NajdBS/2627_ESE_PROJET_BMO/README.md

# 2627_ESE_PROJET_BMO
# Robot BMO - Ramasseur de Canettes
Projet d'Option 3A ESE (2026-2027)

## Équipe
- Najd BEN SAAD
- Achraf AHAL
- Yassin GARAFI
