NajdBS/2627_ESE_PROJET_BMO/docs/Composants_BMO.xlsx

ROBOT GARBAGE COLLECTOR - CODE NAME : BMO
Composant | Reference suggeree | Qte | A quoi ca sert (Role) | Emplacement | Option
Microcontroleur (Cerveau) | STM32G431RBT6 OU STM32G474RBT3 (In Stock: 3,342) | 1 | Controle general, RTOS, asservissement moteurs | Soude sur PCB | Commun (Obligatoire)
Driver Moteurs | DRV8833PWPR | 1 | Pilote les 2 roues motrices (vitesse et sens) | Soude sur PCB | Commun (Obligatoire)
Chargeur + Boost 5V | BQ25896RTWR | 1 | Charge USB-C + alimente le robot en 5V (3.1A) | Soude sur PCB | Commun (Obligatoire)
Regulateur 3.3V | BU33SD5WG-TR | 1 | Alimente le STM32, l ecran et les capteurs I2C | Soude sur PCB | Commun (Obligatoire)
Gyroscope (IMU) | MPU6050 | 1 | Evite que BMO ne devie dans les virages | Soude sur PCB | Commun (Obligatoire)
Prise USB-C | Embase USB-C | 1 | Recharge de la batterie | Soude sur PCB | Commun (Obligatoire)
Prise Programmation | Header SWD (5 pins) | 1 | Flash et debogage du code via ST-Link | Soude sur PCB | Commun (Obligatoire)
Moteurs Roues | DFRobot FIT0483 | 2 | Propulsion differentielle + encodeurs de tours | Branche au PCB | Commun (Obligatoire)
Servo Pince | DFRobot SER0039 | 1 | Ouvre et serre la canette | Branche au PCB | Commun (Obligatoire)
Capteur Couleur | Adafruit APDS-9960 | 1 | Reconnait si la canette est rouge ou verte | Branche au PCB | Commun (Obligatoire)
Capteurs Sol (Anti-chute) | VL53L0X (ToF) | 2 | Detecte le bord de table pour ne pas tomber | Branche au PCB | Commun (Obligatoire)
Batterie | Li-ion 1S (3.7V) | 1 | Alimentation autonome du robot (~2200 mAh) | Branche au PCB | Commun (Obligatoire)
Ecran Visage BMO (Grand) | OLED 1.3 I2C (SH1106 / SSD1306) | 1 | Affiche les expressions / yeux de BMO en grand format | Branche au PCB | Retenu (BMO)
Telemetrie Sans Fil | Module BLE (HM-10) ou ESP | 1 | Envoie les donnees live (batterie, etat) sur PC/tel | Branche au PCB | Retenu (BMO)
LED Blanche Eclairage | LED Blanche Haute Luminosite (5mm/CMS) | 1 | Eclaire la canette dans la pince pour fiabiliser la couleur en zone sombre | Branche au PCB | Retenu (BMO)
LiDAR 360 | LD06 / RPLIDAR | 1 | Vision 360 : voit canettes et autres robots | Branche au PCB | Option A (LiDAR)
Capteurs ToF Avant | VL53L0X | 3 | Detecte les canettes en arc fixe (sans moteur) | Branche au PCB | Option B (3 ToF)
