NajdBS/2627_ESE_PROJET_BMO/BMO/Motors.kicad_sch

## KiCad design BMO/Motors.kicad_sch (2026-11-05)

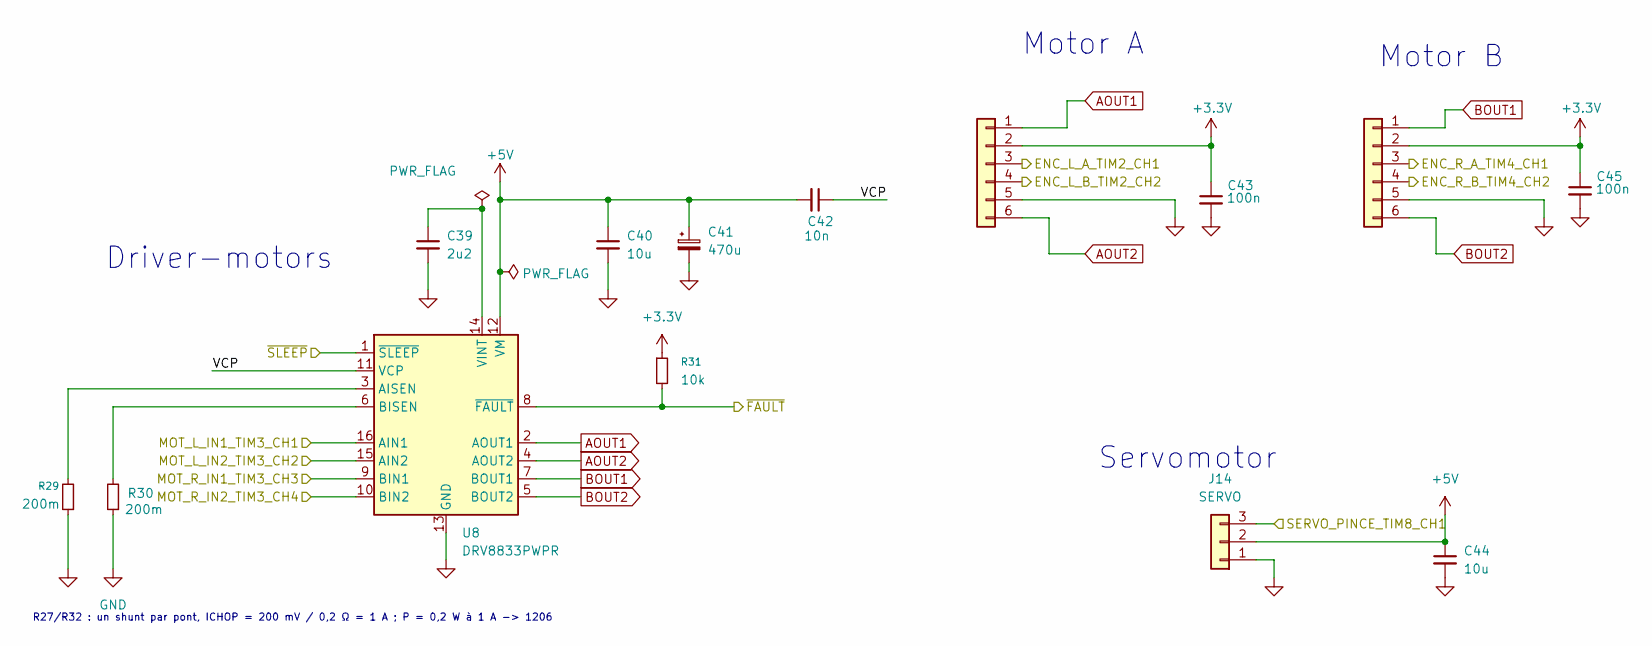
[picture p1: schematic Motors.kicad_sch]

Parts:
C39: 2u2; C_0402_1005Metric; JLCPCB Part # C12530
C40, C44: 10u; C_0603_1608Metric; JLCPCB Part # C96446
C41: 470u; CP_Elec_10x10; JLCPCB Part # C2165185
C42: 10n; C_0402_1005Metric; JLCPCB Part # C15195
C43, C45: 100n; C_0402_1005Metric; JLCPCB Part # C1525
J13, J15: Conn_01x06; JST_XH_S6B-XH-A_1x06_P2.50mm_Horizontal; JLCPCB Part # C157919
J14: SERVO; JST_XH_S3B-XH-A-1_1x03_P2.50mm_Horizontal; JLCPCB Part # C163036
R29: 200m; R_2512_6332Metric; JLCPCB Part # C83749
R30: 200m; R_2512_6332Metric; LCSC C83749
R31: 10k; R_0402_1005Metric; JLCPCB Part # C25744
U8: DRV8833PWPR; HTSSOP-16-1EP_4.4x5mm_P0.65mm_EP3.4x5mm_Mask2.46x2.31mm_The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; JLCPCB Part # C50506

Connections:
+3.3V: C43.1, C45.1, J13.2, J15.2, R31.1
+5V: C40.1, C41.1, C42.2, C44.1, J14.2, U8.12 (VM)
AOUT1: J13.1, U8.2 (AOUT1)
AOUT2: J13.6, U8.4 (AOUT2)
BOUT1: J15.1, U8.7 (BOUT1)
BOUT2: J15.6, U8.5 (BOUT2)
ENC_L_A_TIM2_CH1: J13.3
ENC_L_B_TIM2_CH2: J13.4
ENC_R_A_TIM4_CH1: J15.3
ENC_R_B_TIM4_CH2: J15.4
GND: C39.2, C40.2, C41.2, C43.2, C44.2, C45.2, J13.5, J14.1, J15.5, R29.1, R30.1, U8.13 (GND), U8.17 (GND)
MOT_L_IN1_TIM3_CH1: U8.16 (AIN1)
MOT_L_IN2_TIM3_CH2: U8.15 (AIN2)
MOT_R_IN1_TIM3_CH3: U8.9 (BIN1)
MOT_R_IN2_TIM3_CH4: U8.10 (BIN2)
unnamed: C39.1, U8.14 (VINT)
unnamed: R29.2, U8.3 (AISEN)
unnamed: R30.2, U8.6 (BISEN)
SERVO_PINCE_TIM8_CH1: J14.3
VCP: C42.1, U8.11 (VCP)
~FAULT: R31.2, U8.8 (~FAULT)
~SLEEP: U8.1 (~SLEEP)

Notes on the sheet:
Driver-motors
R27/R32 : un shunt par pont, ICHOP = 200 mV / 0,2 Ω = 1 A ; P = 0,2 W à 1 A -> 1206
Motor A
Servomotor
Motor B
