NajdBS/2627_ESE_PROJET_BMO/BMO/STM32G474RBT3.kicad_sch

## KiCad design BMO/STM32G474RBT3.kicad_sch (2026-11-05)

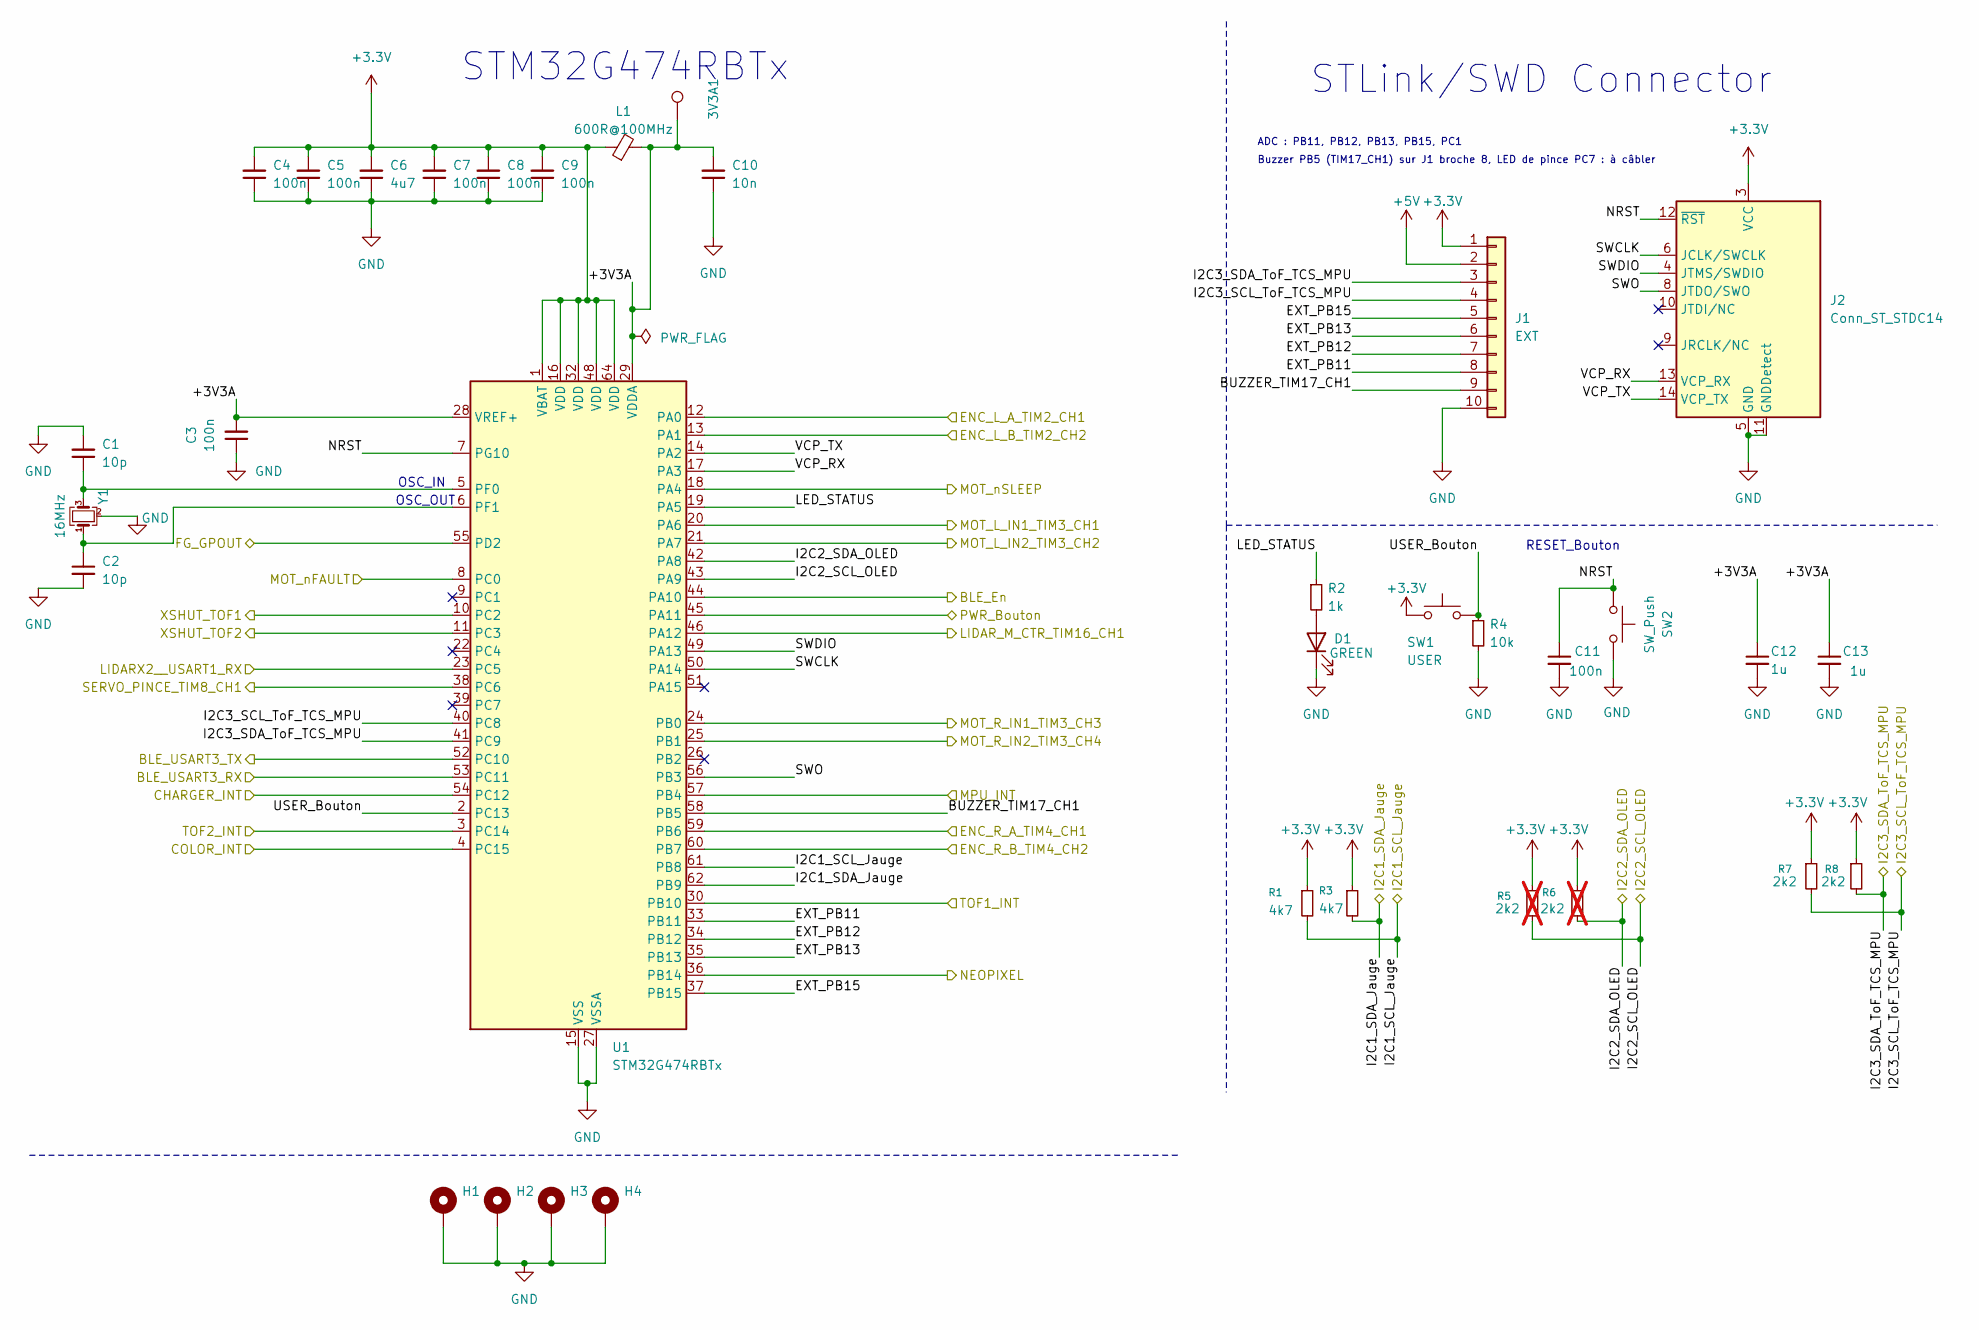
[picture p2: schematic STM32G474RBT3.kicad_sch]

Parts:
3V3A1: TestPoint; TestPoint_Pad_D1.5mm
C1, C2: 10p; C_0402_1005Metric; JLCPCB Part # C32949
C3, C4, C5, C7, C8, C9, C11: 100n; C_0402_1005Metric; JLCPCB Part # C1525
C6: 4u7; C_0603_1608Metric; JLCPCB Part # C19666
C10: 10n; C_0603_1608Metric; JLCPCB Part # C57112
C12, C13: 1u; C_0402_1005Metric; JLCPCB Part # C52923
D1: GREEN; LED_0603_1608Metric; JLCPCB Part # C12624
H1, H2, H3, H4: MountingHole_Pad; MountingHole_3.2mm_M3_Pad_Via
J1: EXT; PinHeader_1x10_P2.54mm_Vertical; JLCPCB Part # C492409
J2: Conn_ST_STDC14; PinHeader_2x07_P1.27mm_Vertical_SMD; JLCPCB Part # C5307809
L1: 600R@100MHz; L_0603_1608Metric; JLCPCB Part # C1002
R1, R3: 4k7; R_0603_1608Metric; JLCPCB Part # C23162
R2: 1k; R_0402_1005Metric; JLCPCB Part # C11702
R4: 10k; R_0402_1005Metric; JLCPCB Part # C25744
R5, R6: 2k2; R_0603_1608Metric; JLCPCB Part # C4190; not fitted
R7, R8: 2k2; R_0603_1608Metric; JLCPCB Part # C4190
SW1: USER; SW_Push_1P1T_NO_CK_KMR2; JLCPCB Part # C72443
SW2: SW_Push; SW_Push_1P1T_NO_CK_KMR2; JLCPCB Part # C72443
U1: STM32G474RBTx; LQFP-64_10x10mm_P0.5mm; JLCPCB Part # C1235414
Y1: 16MHz; Crystal_SMD_3225-4Pin_3.2x2.5mm; JLCPCB Part # C13738

Connections:
+3.3V: C4.2, C5.2, C6.2, C7.2, C8.2, C9.2, J1.1, J2.3 (VCC), L1.1, R1.1, R3.1, R5.2, R6.2, R7.1, R8.1, SW1.1, U1.1 (VBAT), U1.16 (VDD), U1.32 (VDD), U1.48 (VDD), U1.64 (VDD)
+3V3A: 3V3A1.1, C3.2, C10.2, C12.1, C13.1, L1.2, U1.28 (VREF+), U1.29 (VDDA)
+5V: J1.2
BLE_En: U1.44 (PA10)
BLE_USART3_RX: U1.53 (PC11)
BLE_USART3_TX: U1.52 (PC10)
BUZZER_TIM17_CH1: J1.9, U1.58 (PB5)
CHARGER_INT: U1.54 (PC12)
COLOR_INT: U1.4 (PC15)
ENC_L_A_TIM2_CH1: U1.12 (PA0)
ENC_L_B_TIM2_CH2: U1.13 (PA1)
ENC_R_A_TIM4_CH1: U1.59 (PB6)
ENC_R_B_TIM4_CH2: U1.60 (PB7)
EXT_PB11: J1.8, U1.33 (PB11)
EXT_PB12: J1.7, U1.34 (PB12)
EXT_PB13: J1.6, U1.35 (PB13)
EXT_PB15: J1.5, U1.37 (PB15)
FG_GPOUT: U1.55 (PD2)
GND: C1.2, C2.2, C3.1, C4.1, C5.1, C6.1, C7.1, C8.1, C9.1, C10.1, C11.2, C12.2, C13.2, D1.1 (K), H1.1, H2.1, H3.1, H4.1, J1.10, J2.5 (GND), J2.7 (GND), J2.11 (GNDDetect), R4.2, SW2.2, U1.15 (VSS), U1.27 (VSSA), U1.31 (VSS), U1.47 (VSS), U1.63 (VSS), Y1.2 (G), Y1.4 (G)
I2C1_SCL_Jauge: R1.2, U1.61 (PB8)
I2C1_SDA_Jauge: R3.2, U1.62 (PB9)
I2C2_SCL_OLED: R5.1, U1.43 (PA9)
I2C2_SDA_OLED: R6.1, U1.42 (PA8)
I2C3_SCL_ToF_TCS_MPU: J1.4, R7.2, U1.40 (PC8)
I2C3_SDA_ToF_TCS_MPU: J1.3, R8.2, U1.41 (PC9)
LED_STATUS: R2.1, U1.19 (PA5)
LIDARX2__USART1_RX: U1.23 (PC5)
LIDAR_M_CTR_TIM16_CH1: U1.46 (PA12)
MOT_L_IN1_TIM3_CH1: U1.20 (PA6)
MOT_L_IN2_TIM3_CH2: U1.21 (PA7)
MOT_R_IN1_TIM3_CH3: U1.24 (PB0)
MOT_R_IN2_TIM3_CH4: U1.25 (PB1)
MOT_nFAULT: U1.8 (PC0)
MOT_nSLEEP: U1.18 (PA4)
MPU_INT: U1.57 (PB4)
NEOPIXEL: U1.36 (PB14)
NRST: C11.1, J2.12 (~RST), SW2.1, U1.7 (PG10)
unnamed: C1.1, U1.5 (PF0), Y1.3
unnamed: C2.1, U1.6 (PF1), Y1.1
unnamed: D1.2 (A), R2.2
PWR_Bouton: U1.45 (PA11)
SERVO_PINCE_TIM8_CH1: U1.38 (PC6)
SWCLK: J2.6 (JCLK/SWCLK), U1.50 (PA14)
SWDIO: J2.4 (JTMS/SWDIO), U1.49 (PA13)
SWO: J2.8 (JTDO/SWO), U1.56 (PB3)
TOF1_INT: U1.30 (PB10)
TOF2_INT: U1.3 (PC14)
USER_Bouton: R4.1, SW1.2, U1.2 (PC13)
VCP_RX: J2.13 (VCP_RX), U1.17 (PA3)
VCP_TX: J2.14 (VCP_TX), U1.14 (PA2)
XSHUT_TOF1: U1.10 (PC2)
XSHUT_TOF2: U1.11 (PC3)

Notes on the sheet:
Buzzer PB5 (TIM17_CH1) sur J1 broche 8, LED de pince PC7 : à câbler
OSC_IN
RESET_Bouton
OSC_OUT
ADC : PB11, PB12, PB13, PB15, PC1
STLink/SWD Connector
STM32G474RBTx
