NajdBS/2627_ESE_PROJET_BMO/BMO/Sensors.kicad_sch

## KiCad design BMO/Sensors.kicad_sch (2026-11-05)

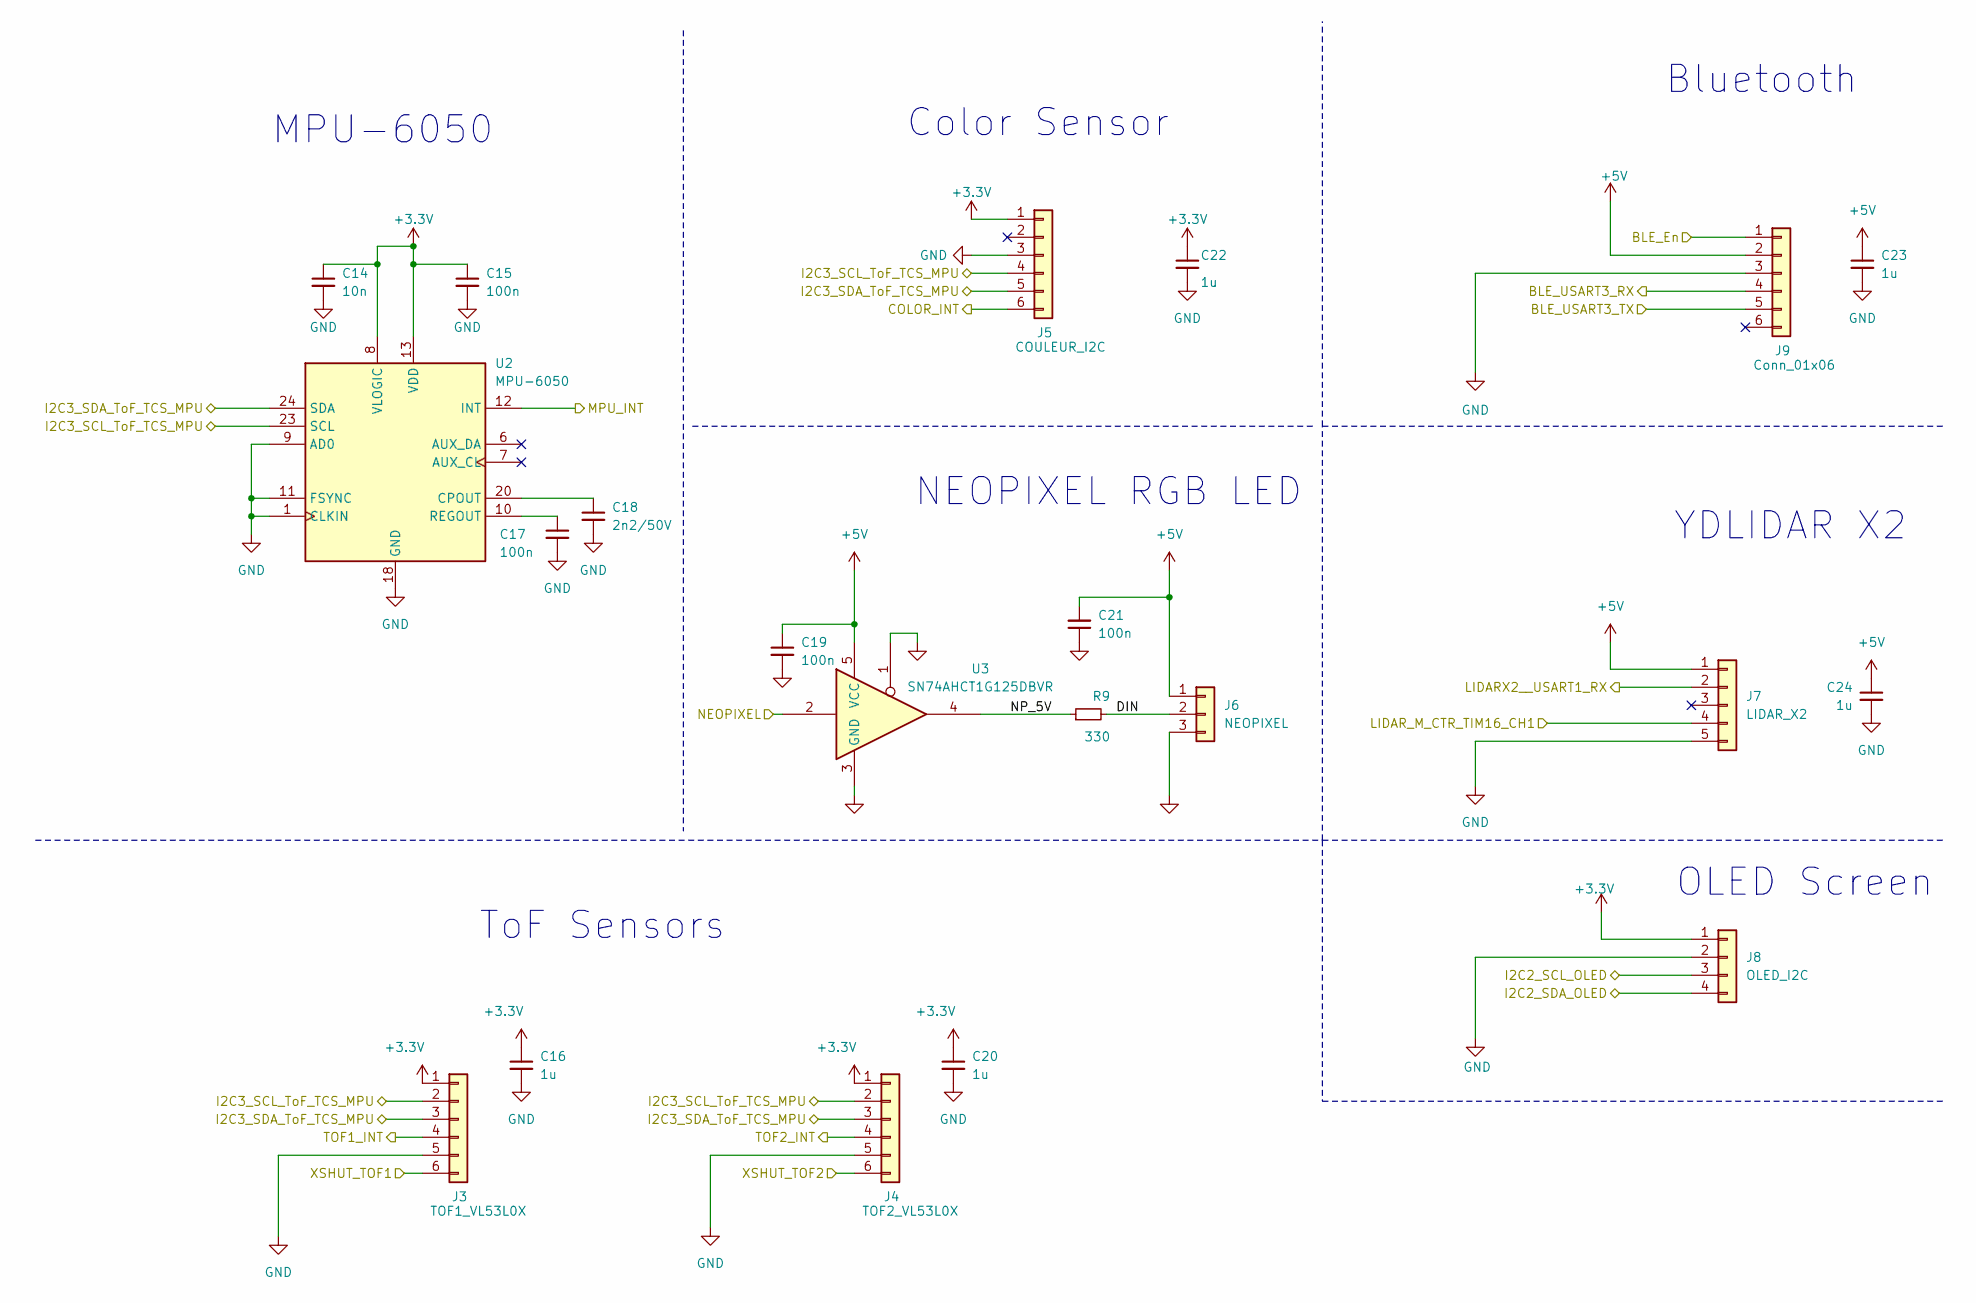
[picture p3: schematic Sensors.kicad_sch]

Parts:
C14: 10n; C_0402_1005Metric; JLCPCB Part # C15195
C15, C17, C19, C21: 100n; C_0402_1005Metric; JLCPCB Part # C1525
C16, C20, C22, C23, C24: 1u; C_0603_1608Metric; JLCPCB Part # C15849
C18: 2n2/50V; C_0402_1005Metric; JLCPCB Part # C77022
J3: TOF1_VL53L0X; JST_XH_S6B-XH-A_1x06_P2.50mm_Horizontal; JLCPCB Part # C157919
J4: TOF2_VL53L0X; JST_XH_S6B-XH-A_1x06_P2.50mm_Horizontal; JLCPCB Part # C157919
J5: COULEUR_I2C; JST_XH_S6B-XH-A_1x06_P2.50mm_Horizontal; JLCPCB Part # C157919
J6: NEOPIXEL; JST_XH_S3B-XH-A-1_1x03_P2.50mm_Horizontal; JLCPCB Part # C163036
J7: LIDAR_X2; JST_XH_S5B-XH-A-1_1x05_P2.50mm_Horizontal; JLCPCB Part # C163038
J8: OLED_I2C; JST_XH_S4B-XH-A_1x04_P2.50mm_Horizontal; JLCPCB Part # C157925
J9: Conn_01x06; JST_XH_S6B-XH-A_1x06_P2.50mm_Horizontal; JLCPCB Part # C157919
R9: 330; R_0402_1005Metric; LCSC C25104
U2: MPU-6050; InvenSense_QFN-24_4x4mm_P0.5mm; JLCPCB Part # C24112
U3: SN74AHCT1G125DBVR; SOT-23-5; JLCPCB Part # C7484

Connections:
+3.3V: C14.1, C15.1, C16.1, C20.1, C22.1, J3.1, J4.1, J5.1, J8.1, U2.8 (VLOGIC), U2.13 (VDD)
+5V: C19.1, C21.2, C23.1, C24.1, J6.1, J7.1, J9.2, U3.5 (VCC)
BLE_En: J9.1
BLE_USART3_RX: J9.4
BLE_USART3_TX: J9.5
COLOR_INT: J5.6
DIN: J6.2, R9.2
GND: C14.2, C15.2, C16.2, C17.2, C18.2, C19.2, C20.2, C21.1, C22.2, C23.2, C24.2, J3.5, J4.5, J5.3, J6.3, J7.5, J8.2, J9.3, U2.1 (CLKIN), U2.9 (AD0), U2.11 (FSYNC), U2.18 (GND), U3.1, U3.3 (GND)
I2C2_SCL_OLED: J8.3
I2C2_SDA_OLED: J8.4
I2C3_SCL_ToF_TCS_MPU: J3.2, J4.2, J5.4, U2.23 (SCL)
I2C3_SDA_ToF_TCS_MPU: J3.3, J4.3, J5.5, U2.24 (SDA)
LIDARX2__USART1_RX: J7.2
LIDAR_M_CTR_TIM16_CH1: J7.4
MPU_INT: U2.12 (INT)
NEOPIXEL: U3.2
NP_5V: R9.1, U3.4
unnamed: C17.1, U2.10 (REGOUT)
unnamed: C18.1, U2.20 (CPOUT)
TOF1_INT: J3.4
TOF2_INT: J4.4
XSHUT_TOF1: J3.6
XSHUT_TOF2: J4.6

Notes on the sheet:
ToF Sensors
Color Sensor
YDLIDAR X2
NEOPIXEL RGB LED
MPU-6050
OLED Screen
Bluetooth
