NajdBS/2627_ESE_PROJET_BMO/(commit log)

2026-09-21 ADD docs, readme and gitignore
    [Composants_BMO.xlsx]
2026-09-24 update pcb
    [BMO.kicad_sch, STM32G474RBT3.kicad_sch, Sensors.kicad_sch]
2026-09-28 Update KiCad files, add Power schematic
    [BMO.kicad_sch, Power.kicad_sch]
2026-09-30 Updated Power schematic, Added Motors driver schematic
    [BMO.kicad_sch, Motors.kicad_sch, Power.kicad_sch]
2026-09-30 Update sensor and MCU files
    [BMO.kicad_pcb, BMO.kicad_sch, Motors.kicad_sch, Power.kicad_sch, STM32G474RBT3.kicad_sch, Sensors.kicad_sch]
2026-09-30 changed the charger to BQ25896RTW and updated the shematic
    [BMO.kicad_sch, Power.kicad_sch]
2026-10-05 Update PCB modifications
    [BMO.kicad_sch, Motors.kicad_sch, Power.kicad_sch, STM32G474RBT3.kicad_sch, Sensors.kicad_sch]
2026-10-05 Schéma prêt pour le PCB
    [BMO.kicad_sch, Motors.kicad_sch, Power.kicad_sch, STM32G474RBT3.kicad_sch, Sensors.kicad_sch]
2026-10-07 pcb(layout): finalize placement post-review and initiate routing
    [BMO.kicad_pcb, Motors.kicad_sch, Power.kicad_sch, STM32G474RBT3.kicad_sch, Sensors.kicad_sch]
2026-10-07 Mise à jour des fichiers PCB
    [BMO.kicad_pcb, Power.kicad_sch, STM32G474RBT3.kicad_sch]
2026-10-08 feat(pcb): update placement, fallback I2C, and route MCU, sensors, and external pins
    [BMO.kicad_pcb, STM32G474RBT3.kicad_sch]
2026-10-09 updated the shematic and routed the pcb
    [BMO.kicad_pcb, Power.kicad_sch, STM32G474RBT3.kicad_sch]
2026-10-10 feat(pcb): complete initial routing (v1) pending verification
    [BMO.kicad_pcb, Power.kicad_sch, STM32G474RBT3.kicad_sch]
2026-10-11 refactor(pcb): optimize trace routing and clearances
2026-10-12 refactor(pcb): optimize clearances
2026-10-12 added on/off button, CSV completed and pcb updated
2026-10-16 Finalize PCB design and validate layout
    - Apply layout and routing improvements
    - Update components and footprint adjustments
    - Run and pass design rule checks (DRC)
2026-10-17 Finalize PCB design and generate BOM and CPL files
2026-10-17 feat(pcb): finalize design and generate manufacturing BOM and CPL
2026-10-17 Update USB-C connector to in-stock part, align CPL coordinates and finalize BOM
2026-10-18 fix(pcb): correct USB-C connector placement and update CPL coordinates
2026-10-18 fix(pcb): adjust fuel gauge IC placement and alignment
